hubbellc/Self-Charging-Robot/Blocks/Housing/Sheet 2.JPG

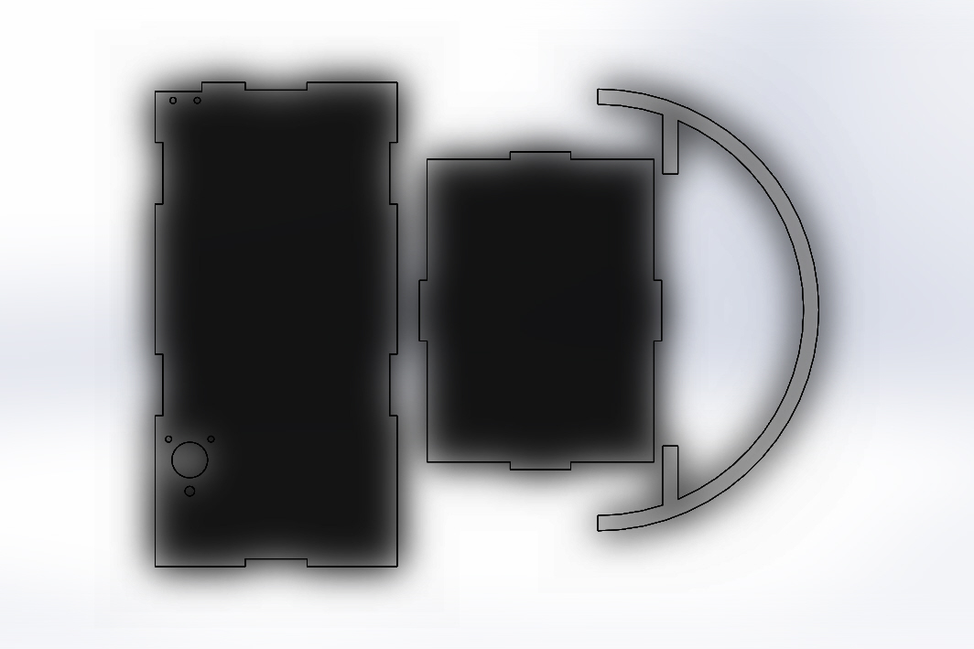
Blocks/Housing/Sheet 2.JPG
