hubbellc/Self-Charging-Robot/Robot Interface.pdf

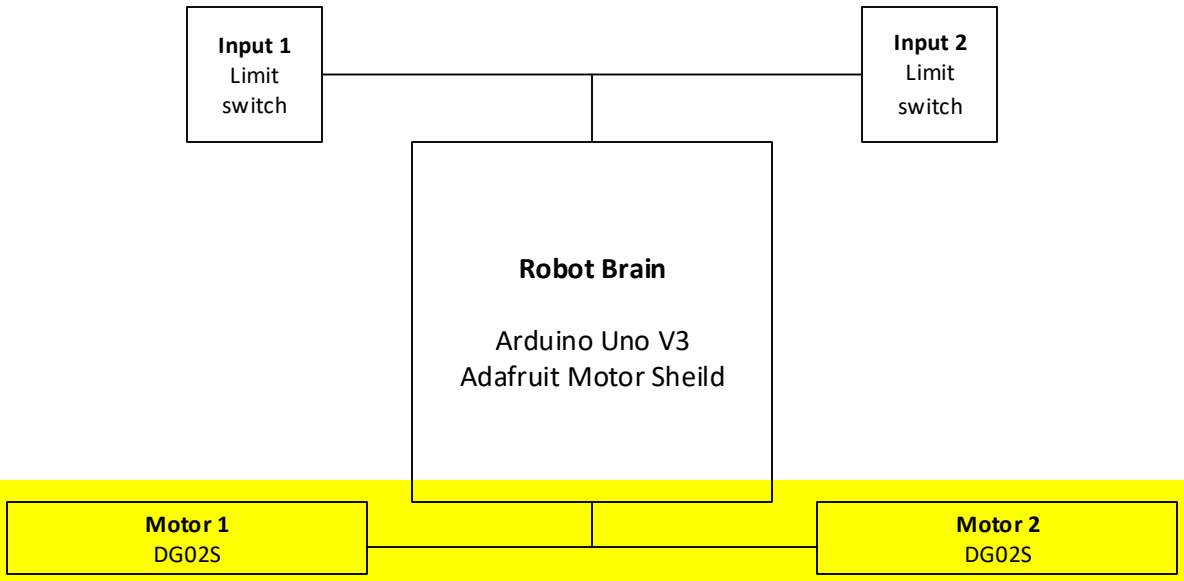
[picture p3: figure]
Robot Brain; Arduino Uno V3 Adafruit Motor Sheild; Motor 2 DG02S; Motor 1 DG02S; Input 2 Limit switch; Input 1 Limit switch
