hubbellc/Self-Charging-Robot/Blocks/Movement Block/Movement Sensing Motor Comm Block Check-Off.pdf

# All Block Check-Off

# Caleb Hubbell

# Block Diagram

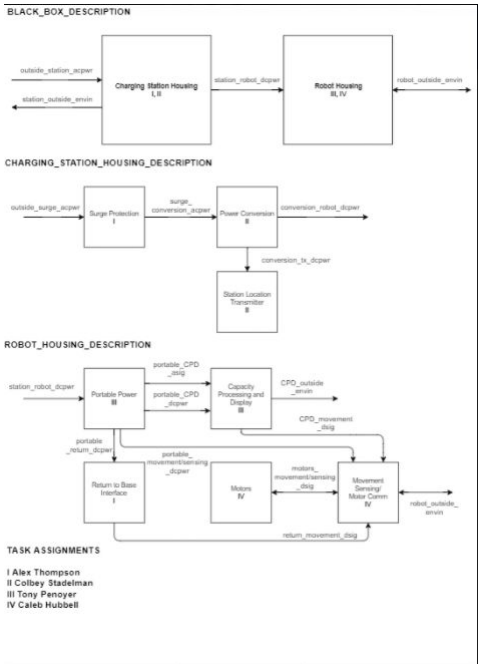
[picture p15: figure]

# Functional Overview - Motor


# Interface Verification for System Integration - Motor


Interface | Properties
robot_outside_envin | ● | Surfaces include: tile, short carpet, concrete
- Obstacles include: walls, chair legs, cords, clothing
robot_outside_motion | ● | Speed on all surfaces must be greater than 0.3 m/s
- Max speed > 0.3 m/s
- 10 min or greater time in motion
capacity/reg_motors_dcpwr | ● | 3-12 V DC
- 0 - 0.7 A
- 10% tolerance on input parameters
motors_movement/sensing_dsig | ● | PWM DC signal powering 2 motors
- PWM frequency of 1.6KHz.
- Draw of 0 - 0.45A
- Duty cycle of 0-40%
- 2 active high inputs; 5V high, 0V low

# Testing Plan Overview - Motor

## 2 Steps:

## A. Top Speed No Load Test B. Top Speed Max Current Draw Test

## Conclusion:

If the block passes all of the listed tests, all interface properties have been verified and the block is ready for inclusion into the system.

# Schematic and Testing Setup - Motor


# Test Videos - Motor

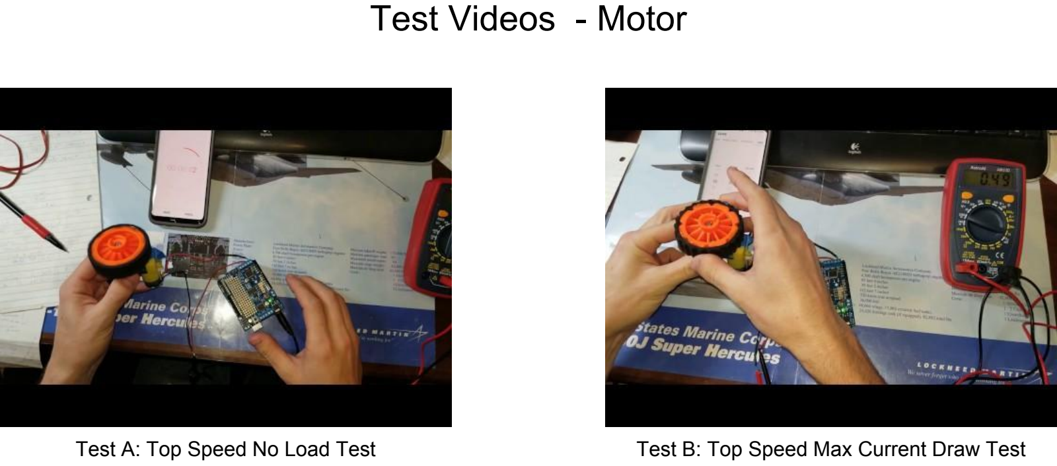
[picture p16: page 7]

Test A: Top Speed No Load Test | Test B: Top Speed Max Current Draw Test

# Test Results - Motor

### Numerical Results:

A. V = 3.53V. I = 0.1A. R = 35.5Ω. RPM = 150.

### Linear Velocity = 0.93m/s

B. V = 3.35V. I= 0.5A. R = 6.7Ω. RPM = 54.

### Linear Velocity = 0.33m/s

### Results: Passed

Both linear velocities were above the required minimum velocity of 0.3m/s. This demonstrates that the motor block is ready to be incorporated into the system for further testing and should not result in system damage or malfunctions.

# Functional Overview - Movement Sensing / Motor Comm


# Interface Verification for System Integration - Movement Sensing / Motor Comm

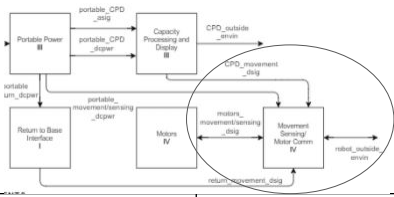
[picture p17: figure]

Interface | Properties
robot_outside_envin | ● | Surfaces include: tile, short carpet, concrete
- Obstacles include: walls, chair legs, cords, clothing
return_movement/sension_dsig | ● | Function calls which demand motor movement in all 4 directions
motors_movement/sensing_dsig | ● | PWM DC signal powering 2 motors
- PWM frequency of 1.6KHz.
- Draw of 0 - 0.45A
- Duty cycle of 0-40%
- 2 active high inputs; 5V high, 0V low

# Testing Plan Overview - Movement Sensing / Motor Comm

## 5 Steps:

## A. Setup B. Forward movement test C. Left object test D. Right object test E. Front object test

## Conclusion:

If the block passes all of the listed tests, all interface properties have been verified and the block is ready for inclusion into the system.

# Schematic and Testing Setup - Movement Sensing / Motor Comm

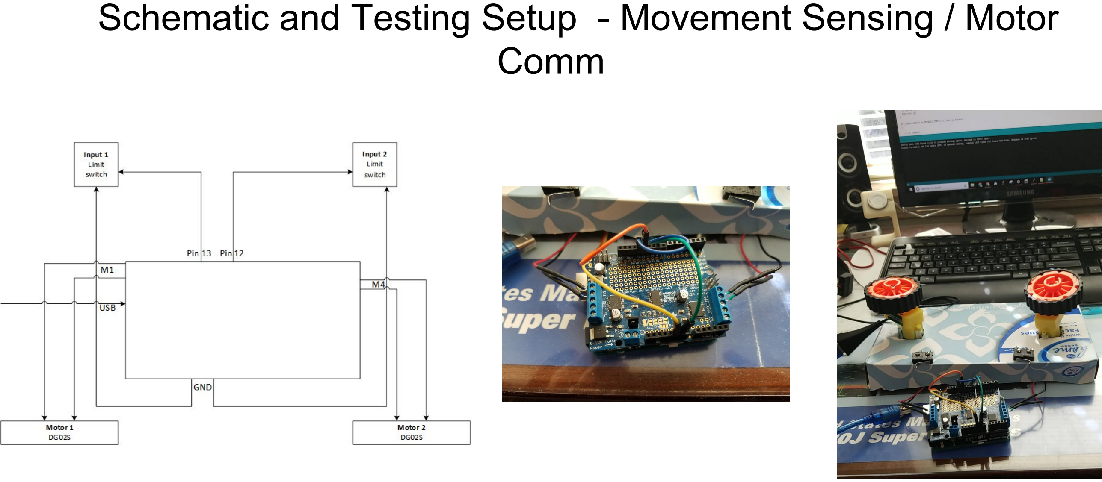
[picture p18: page 12]

# Test Video - Movement Sensing / Motor Comm

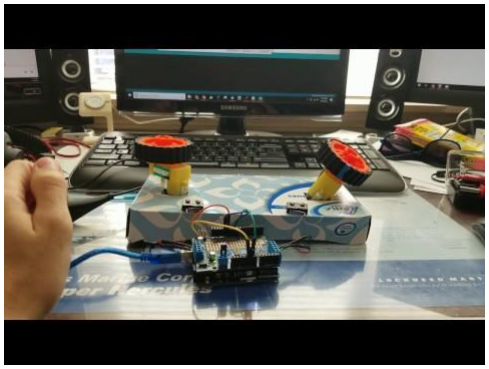
[picture p19: figure]

### Testing the object detection / avoidance

# Test Results - Movement Sensing / Motor Comm

### Results: All Passed

The robot accurately responded to all provided inputs. This demonstrates that the motor block is ready to be incorporated into the system for further testing and should not result in system damage or malfunctions.

# Add’n Block

## Robot Housing

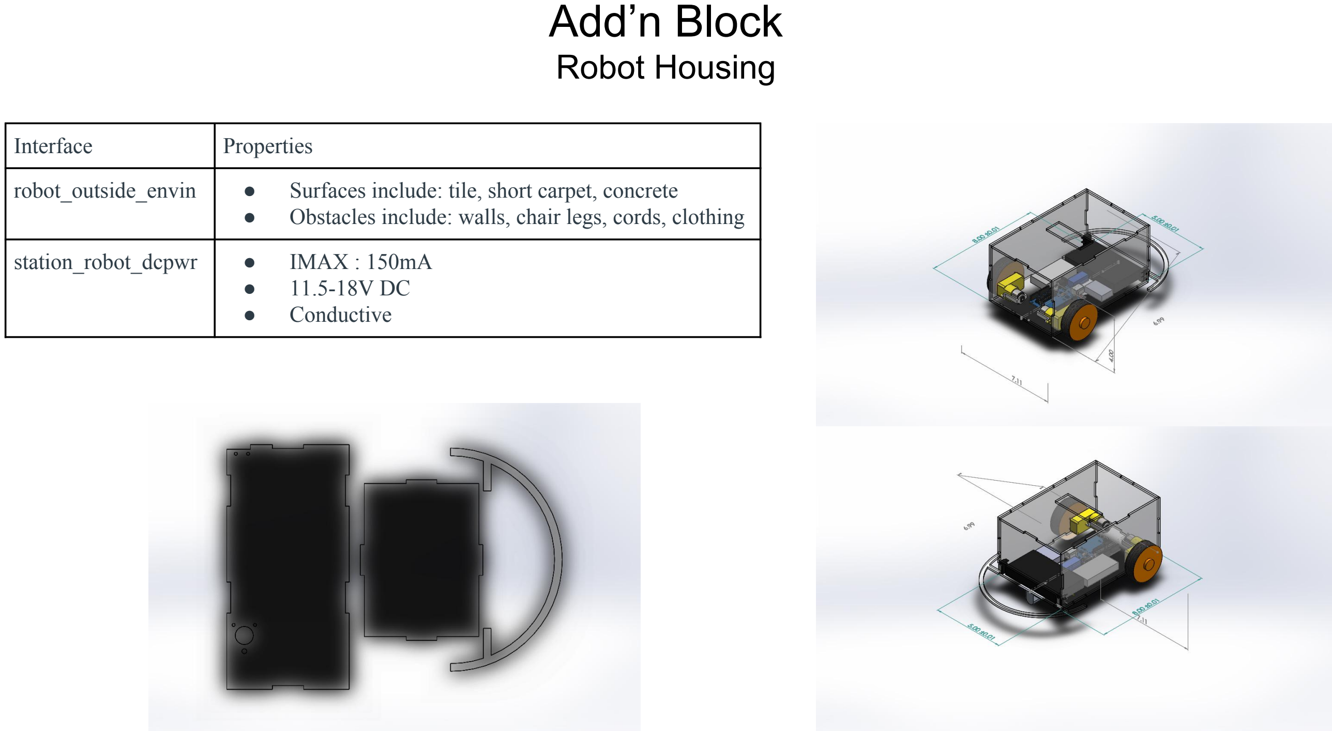
[picture p20: page 15]

Interface | Properties
robot_outside_envin | ● | Surfaces include: tile, short carpet, concrete
- Obstacles include: walls, chair legs, cords, clothing
station_robot_dcpwr | ● | IMAX : 150mA
- 11.5-18V DC
- Conductive
