hubbellc/Self-Charging-Robot/Block Diagram.pdf

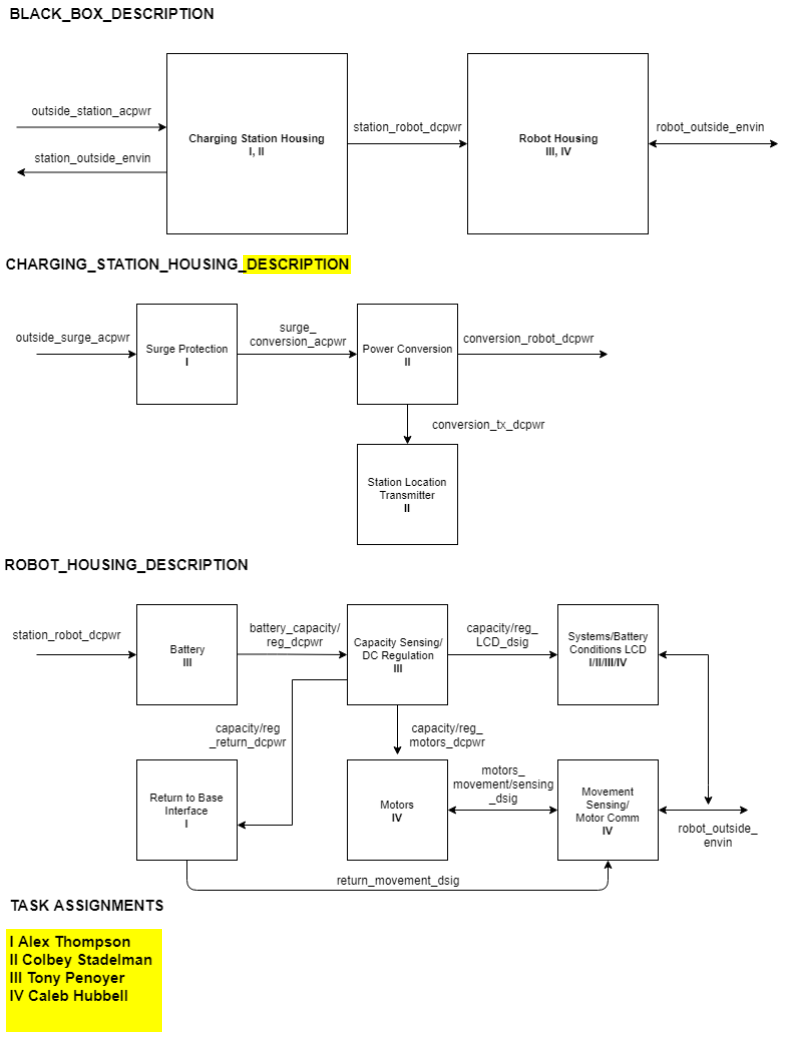
[picture p21: figure]
