hubbellc/Self-Charging-Robot/Blocks/Housing/Robot1.JPG

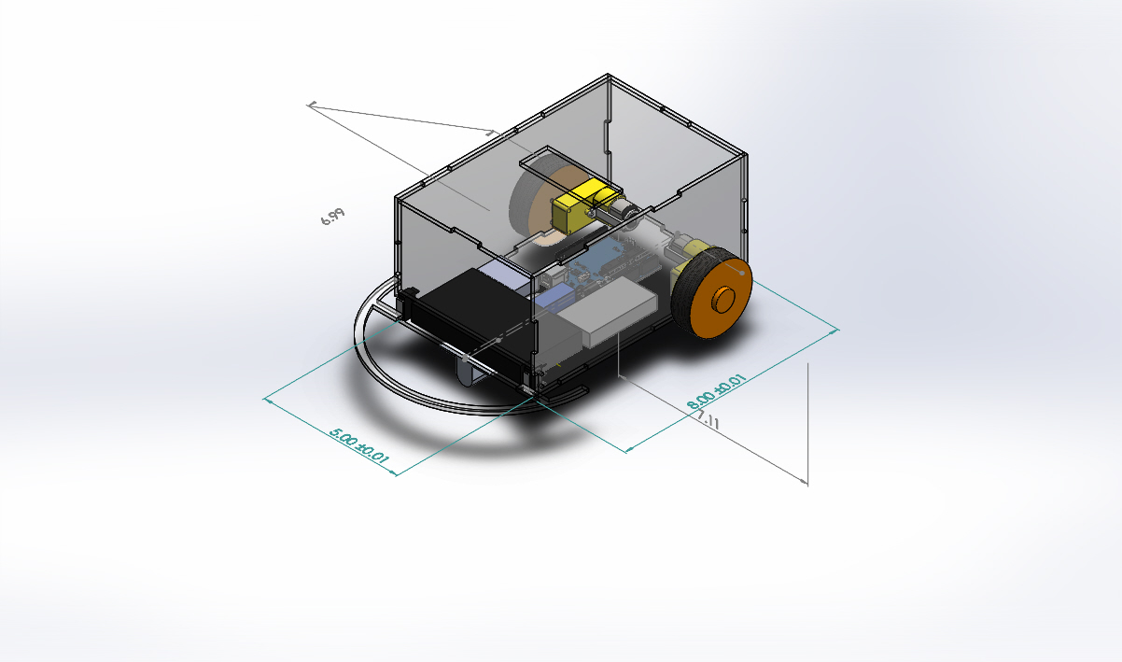
Blocks/Housing/Robot1.JPG
