hubbellc/Self-Charging-Robot/Blocks/Housing/Robot2.JPG

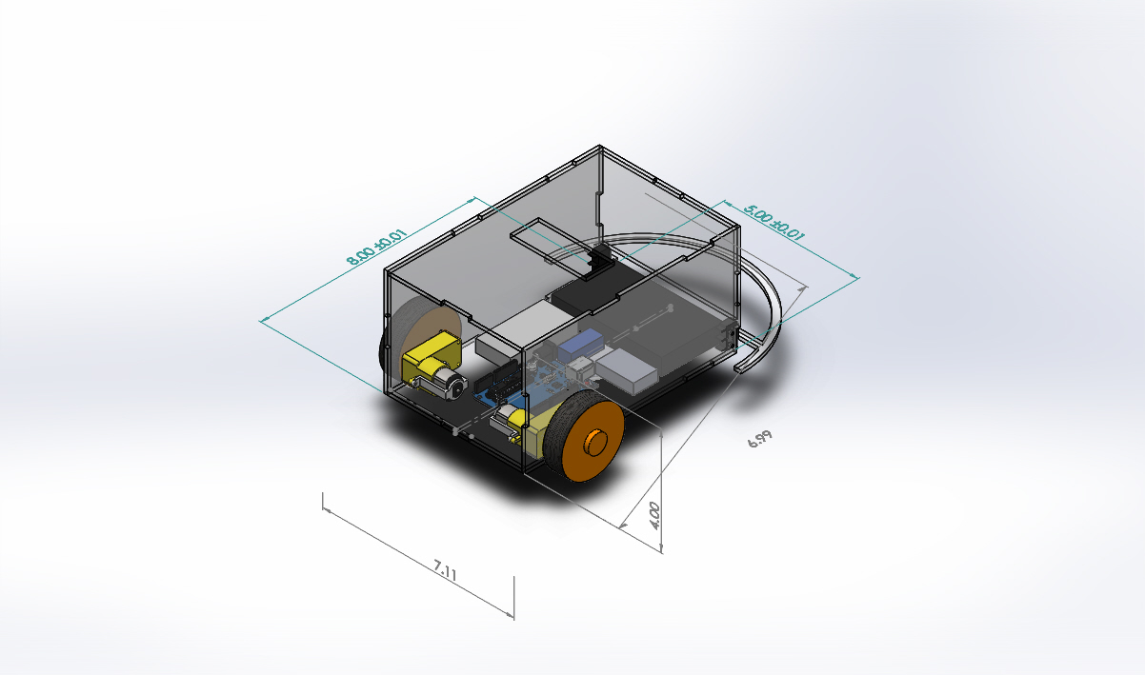
Blocks/Housing/Robot2.JPG
