hubbellc/Self-Charging-Robot/Drawings/Sheet 1.SLDASM

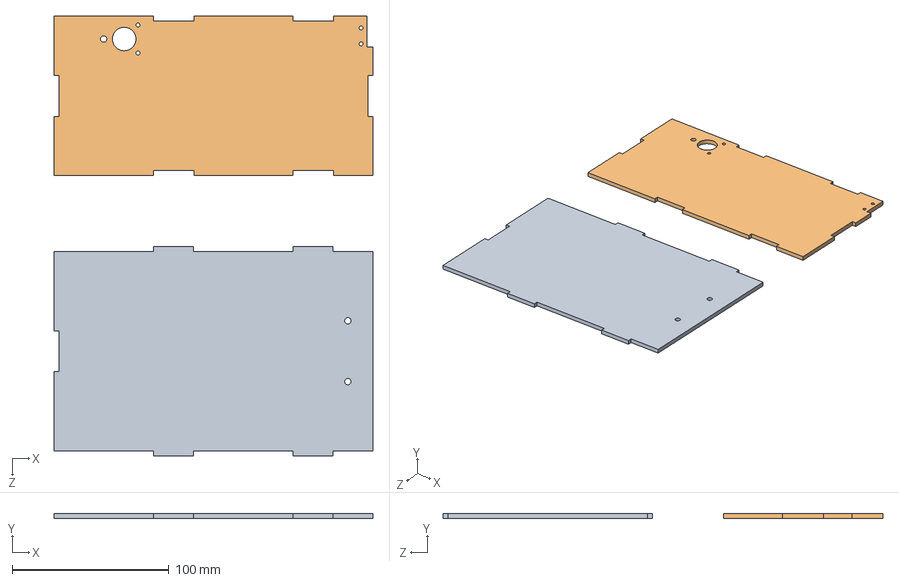
[picture p24: CAD file, 2018-05-14]
Drawings/Sheet 1.SLDASM
203.2 x 3.17 x 280.0 mm
Bottom
Long Side
