hubbellc/Self-Charging-Robot/Drawings/User Library-arduino_uno.sldasm

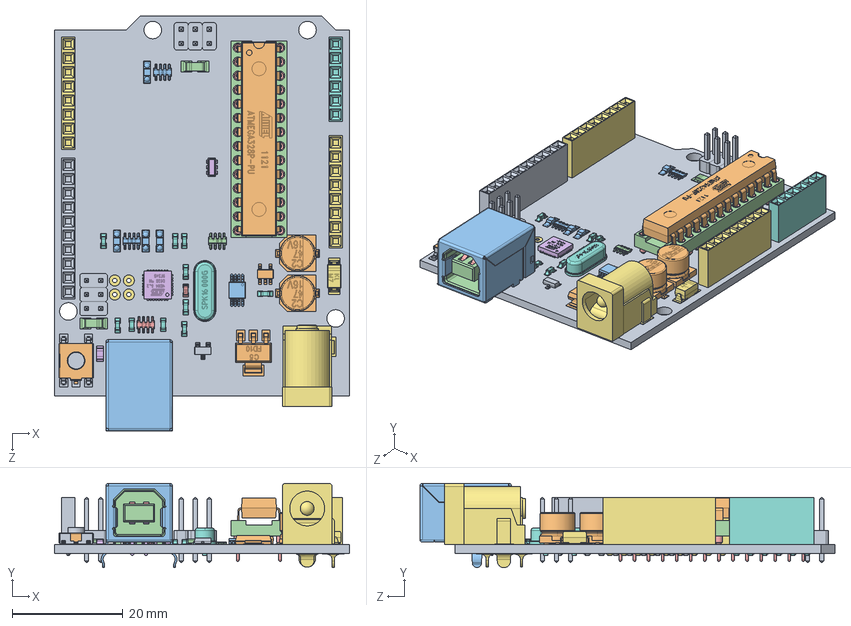
[picture p25: CAD file, 2018-05-14]
Drawings/User Library-arduino_uno.sldasm
53.3 x 15.2 x 74.9 mm
User Library-arduino_uno_unoboard blue
User Library-arduino_uno_47uf CAP Dcase x 2
User Library-arduino_uno_USB SHELL
User Library-arduino_uno_USB core
User Library-arduino_uno_usb top contact x 2
User Library-arduino_uno_usb btm contact x 2
User Library-arduino_uno_power jack
User Library-arduino_uno_crystal
User Library-arduino_uno_2pin_header__02 x 6
User Library-arduino_uno_nano - reg
User Library-arduino_uno_led x 4
User Library-arduino_uno_dip28
User Library-arduino_uno_dip socket pin x 28
User Library-arduino_uno_atmega16u2
User Library-arduino_uno_8 PORT HEADER x 2
User Library-arduino_uno_6 PORT HEADER
User Library-arduino_uno_10 PORT HEADER
User Library-arduino_uno_ATMEL328P
User Library-arduino_uno_102 RESISTOR PACK x 2
User Library-arduino_uno_103 RESISTOR PACK
User Library-arduino_uno_220 RESISTOR PACK
User Library-arduino_uno_16mhz crystal - measured
User Library-arduino_uno_PADS001
User Library-arduino_uno_603 cap on pad x 8
User Library-arduino_uno_ssot3
User Library-arduino_uno_lmv358
User Library-arduino_uno_lp2985dgkr
User Library-arduino_uno_cd1206 diode x 2
User Library-arduino_uno_603 resistor
User Library-arduino_uno_blm21
User Library-arduino_uno_m7 diode
User Library-arduino_uno_MLC0603 x 2
User Library-arduino_uno_RESET CORE
User Library-arduino_uno_RESET
