hubbellc/Self-Charging-Robot/Drawings/Sheet 3.SLDASM

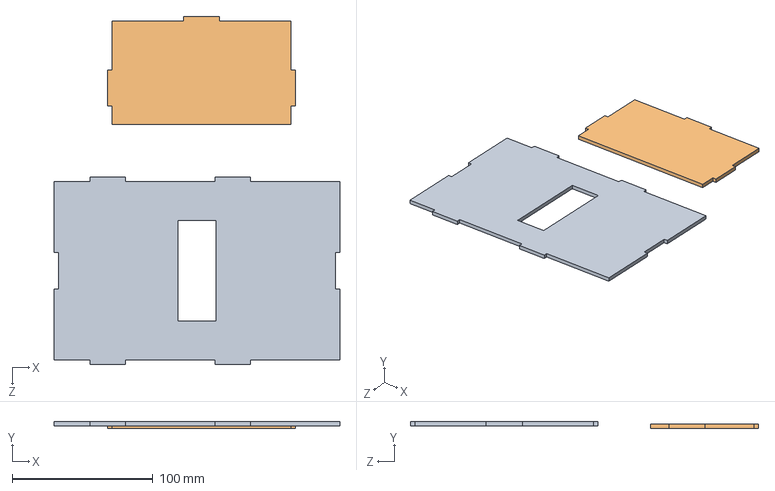
[picture p26: CAD file, 2018-05-14]
Drawings/Sheet 3.SLDASM
203.2 x 4.76 x 247.4 mm
Top
Front
