hubbellc/Self-Charging-Robot/Drawings/Sheet 2.SLDASM

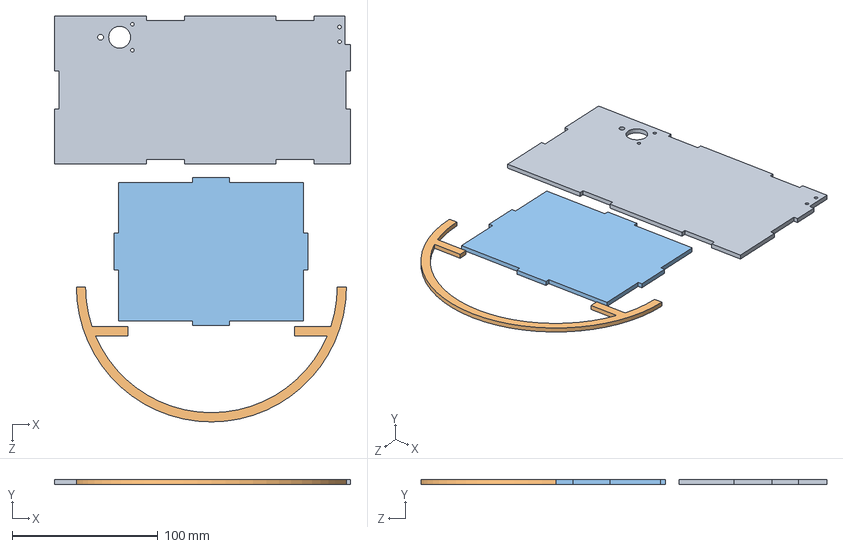
[picture p27: CAD file, 2018-05-14]
Drawings/Sheet 2.SLDASM
203.2 x 3.17 x 278.6 mm
Long Side
Bumper
Short Side
