hubbellc/Self-Charging-Robot/Drawings/JD Power.SLDPRT

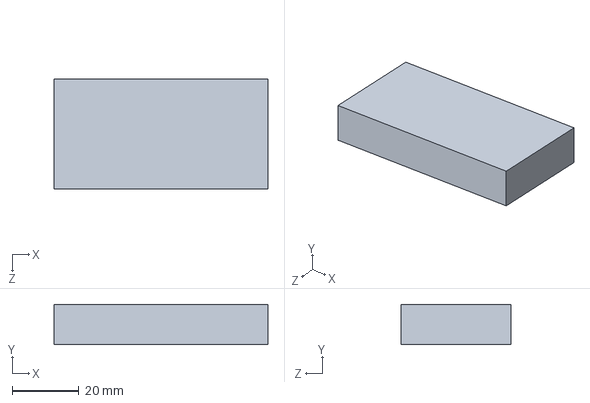
[picture p29: CAD file, 2018-05-14]
Drawings/JD Power.SLDPRT
64.0 x 12.0 x 33.0 mm
