hubbellc/Self-Charging-Robot/Drawings/Bumper.SLDPRT

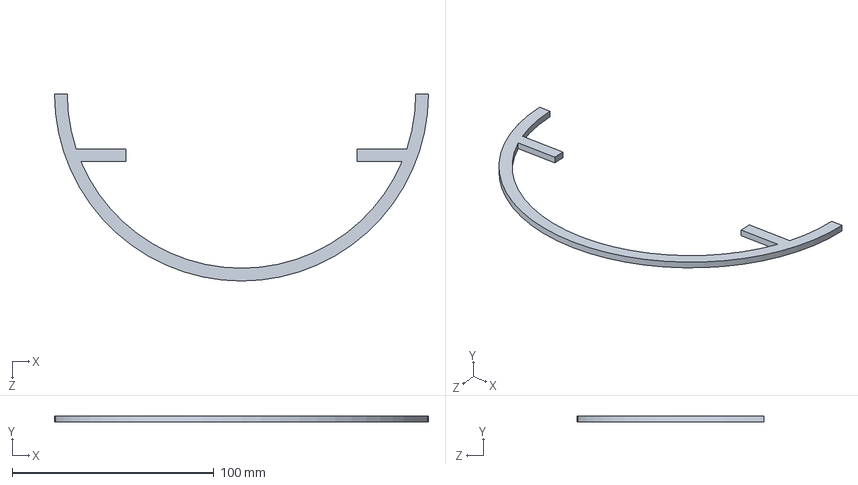
[picture p30: CAD file, 2018-05-14]
Drawings/Bumper.SLDPRT
185.4 x 3.17 x 92.7 mm
