hubbellc/Self-Charging-Robot/Drawings/Bottom.SLDPRT

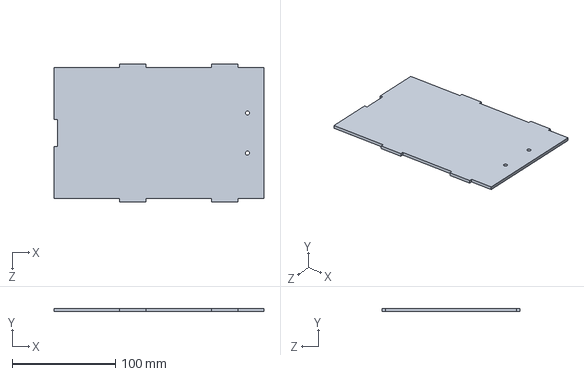
[picture p31: CAD file, 2018-05-14]
Drawings/Bottom.SLDPRT
203.2 x 3.17 x 133.4 mm
