hubbellc/Self-Charging-Robot/Drawings/Wheel.SLDPRT

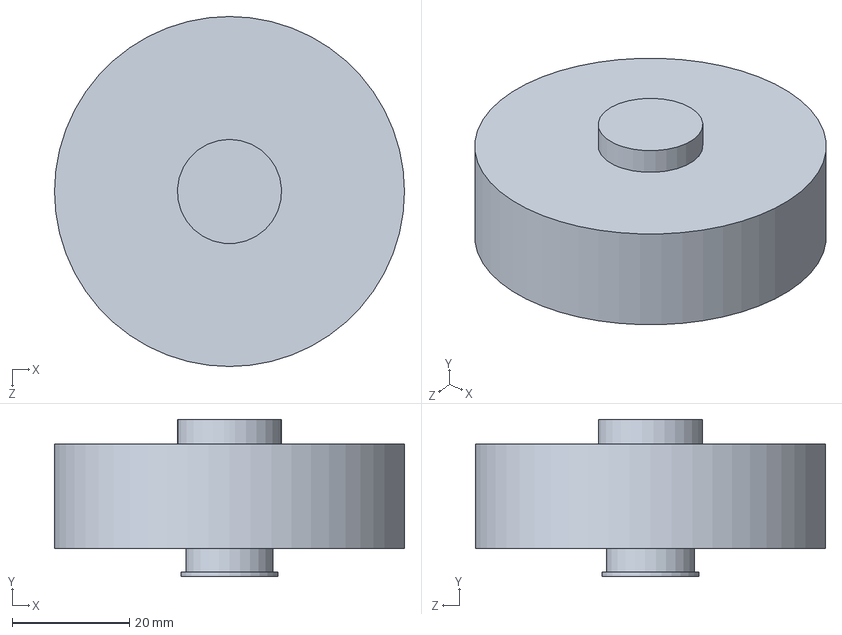
[picture p32: CAD file, 2018-05-14]
Drawings/Wheel.SLDPRT
59.7 x 26.8 x 59.7 mm
