hubbellc/Self-Charging-Robot/Drawings/Battery.SLDPRT

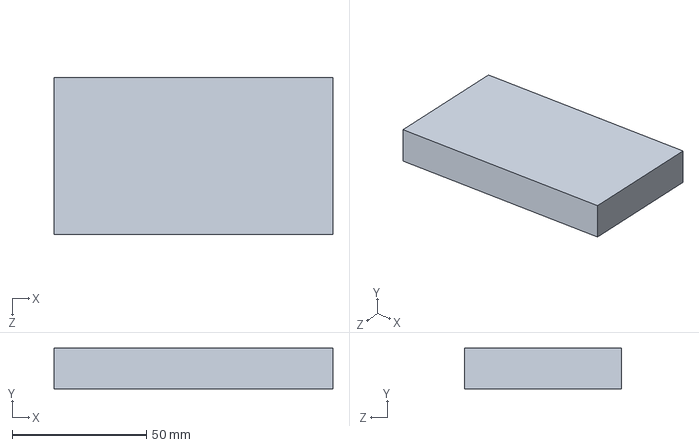
[picture p33: CAD file, 2018-05-14]
Drawings/Battery.SLDPRT
103.9 x 15.2 x 58.4 mm
