hubbellc/Self-Charging-Robot/Drawings/Front.SLDPRT

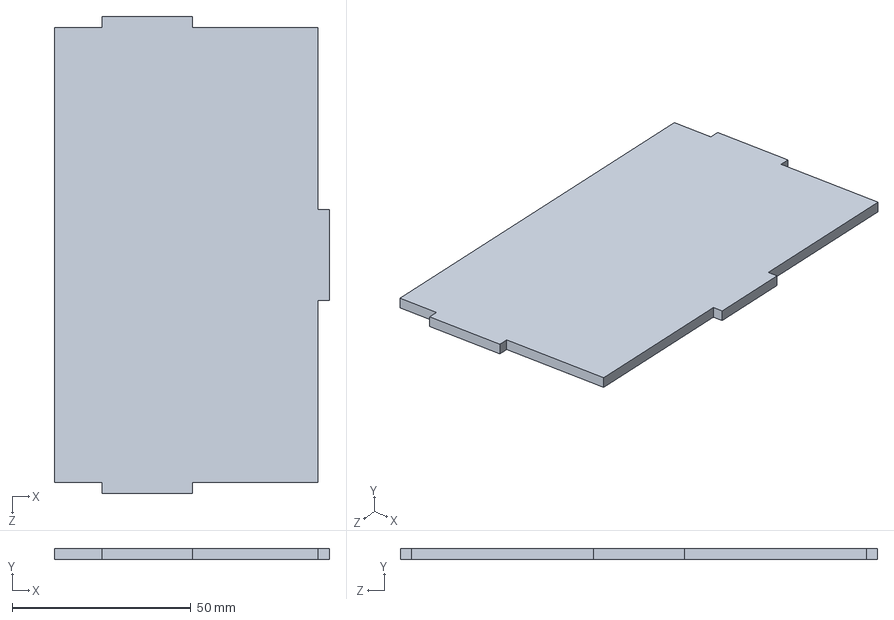
[picture p34: CAD file, 2018-05-14]
Drawings/Front.SLDPRT
76.8 x 3.17 x 133.4 mm
