hubbellc/Self-Charging-Robot/Drawings/Top.SLDPRT

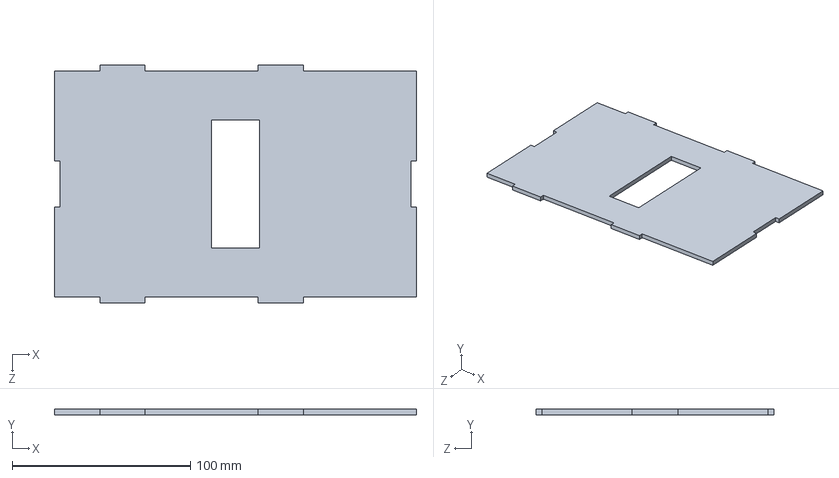
[picture p35: CAD file, 2018-05-14]
Drawings/Top.SLDPRT
203.2 x 3.17 x 133.4 mm
