hubbellc/Self-Charging-Robot/Drawings/Roller.SLDPRT

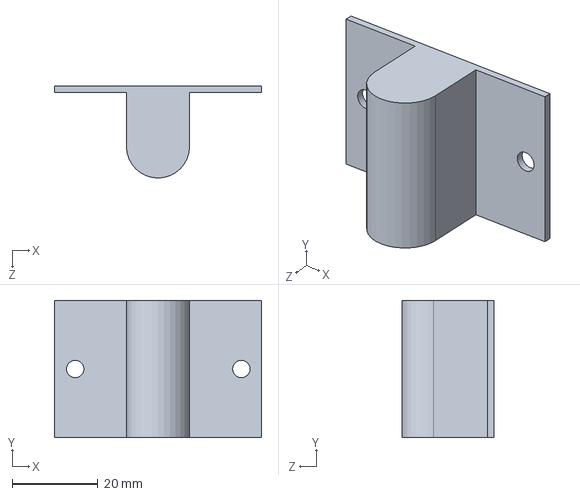
[picture p36: CAD file, 2018-05-14]
Drawings/Roller.SLDPRT
48.3 x 32.0 x 21.5 mm
