hubbellc/Self-Charging-Robot/Drawings/User Library-MINI DC GearBox DG02S 48-1.SLDPRT

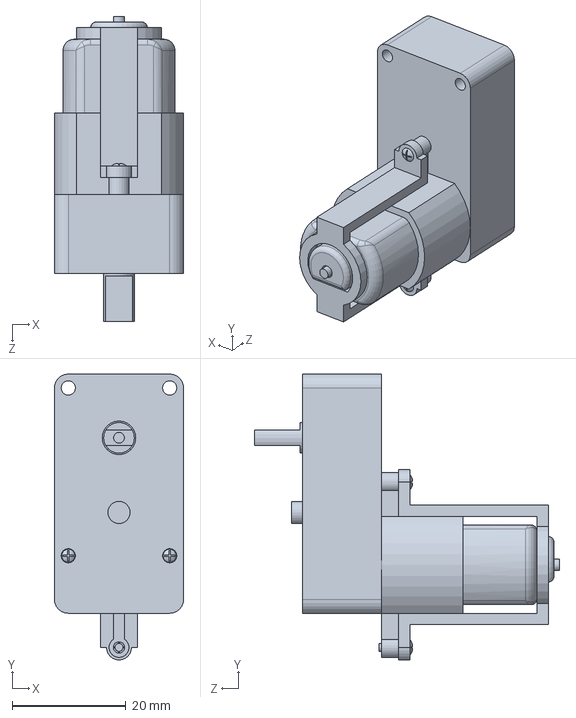
[picture p37: CAD file, 2018-05-14]
Drawings/User Library-MINI DC GearBox DG02S 48-1.SLDPRT
22.7 x 50.2 x 53.6 mm
