hubbellc/Self-Charging-Robot/Drawings/Short Side.SLDPRT

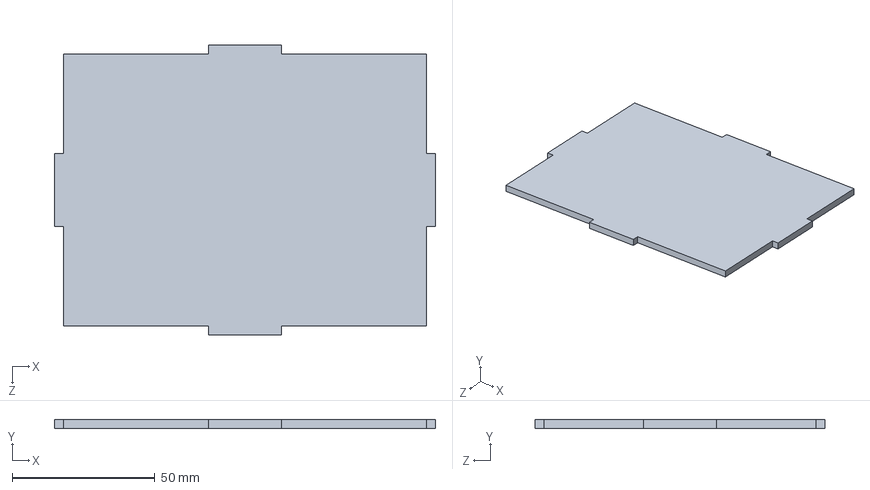
[picture p38: CAD file, 2018-05-14]
Drawings/Short Side.SLDPRT
133.3 x 3.17 x 101.6 mm
