hubbellc/Self-Charging-Robot/Drawings/Compass.SLDPRT

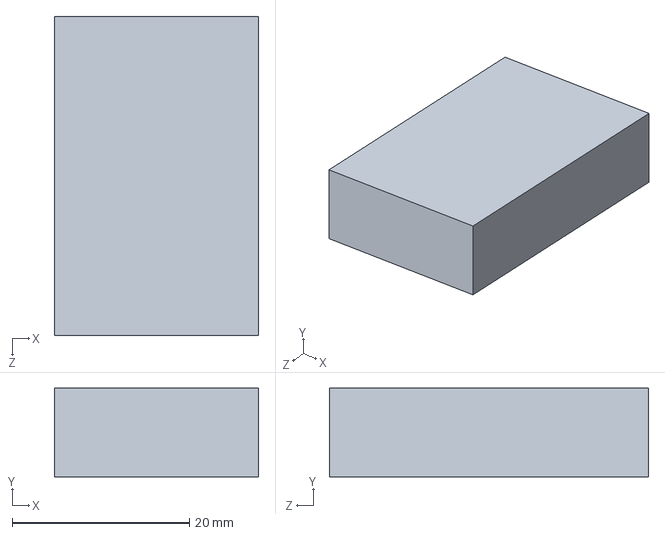
[picture p39: CAD file, 2018-05-14]
Drawings/Compass.SLDPRT
23.0 x 10.0 x 36.0 mm
