hubbellc/Self-Charging-Robot/Drawings/Long Side.SLDPRT

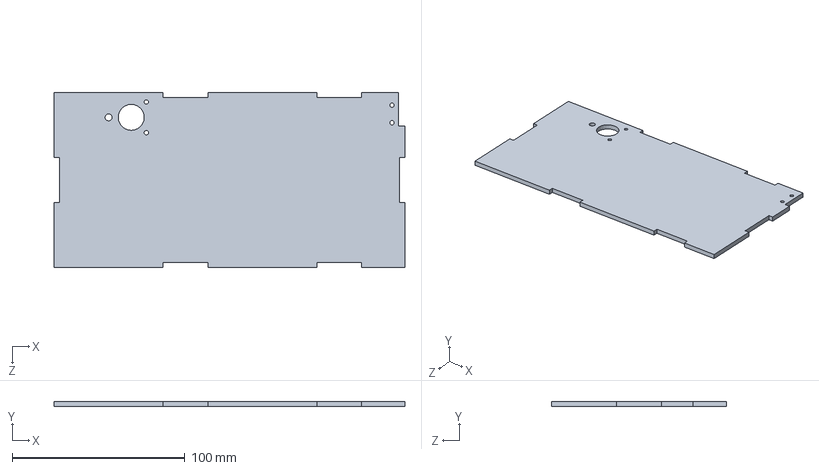
[picture p40: CAD file, 2018-05-14]
Drawings/Long Side.SLDPRT
203.2 x 3.17 x 101.6 mm
