hubbellc/Self-Charging-Robot/Drawings/ACS Module.SLDPRT

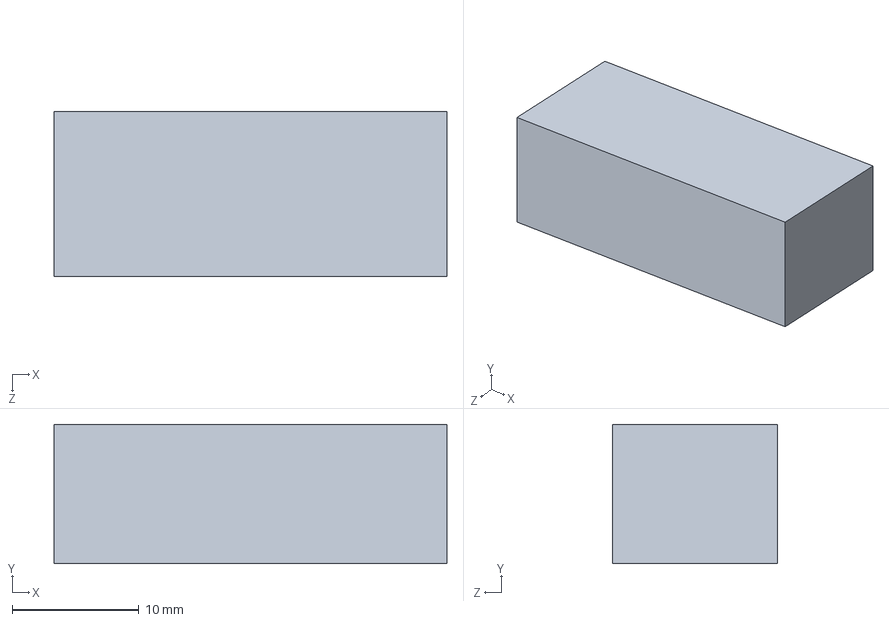
[picture p41: CAD file, 2018-05-14]
Drawings/ACS Module.SLDPRT
31.0 x 11.0 x 13.0 mm
