hubbellc/Self-Charging-Robot/Drawings/Limit Switch.SLDPRT

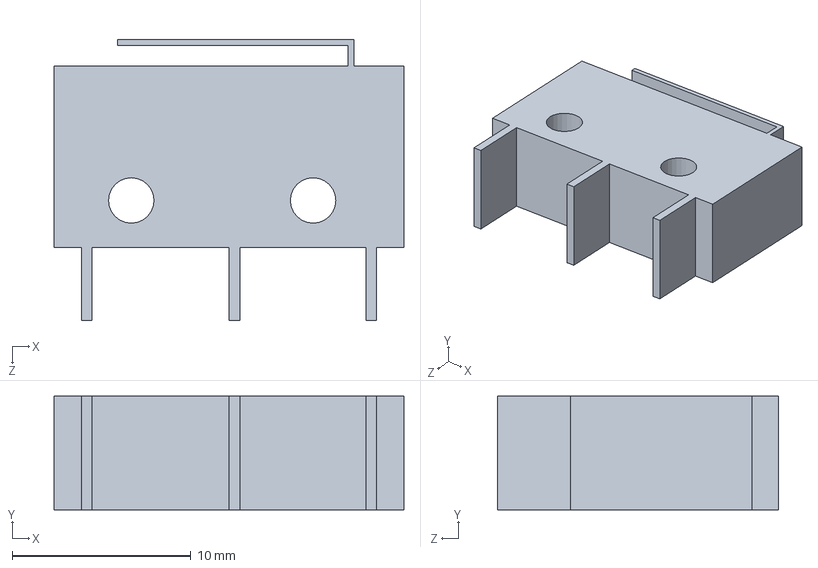
[picture p42: CAD file, 2018-05-14]
Drawings/Limit Switch.SLDPRT
19.6 x 6.35 x 15.7 mm
