hubbellc/Self-Charging-Robot/Drawings/Color Sensor.SLDPRT

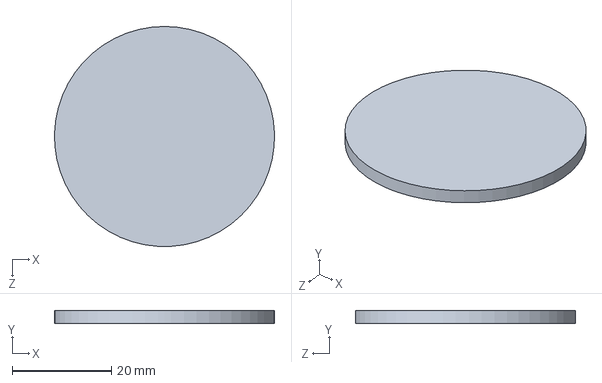
[picture p43: CAD file, 2018-05-14]
Drawings/Color Sensor.SLDPRT
44.4 x 2.54 x 44.5 mm
