hubbellc/Self-Charging-Robot/(list of files, cad)

Other CAD files:
Drawings/DXF's/Sheet 3.SLDPRT
Drawings/User Library-arduino_uno_10 PORT HEADER.sldprt
Drawings/DXF's/Sheet 2.SLDPRT
Drawings/User Library-arduino_uno_ATMEL328P.sldprt
Drawings/DXF's/Sheet 1.SLDPRT
Drawings/User Library-arduino_uno_RESET CORE.sldprt
Drawings/User Library-arduino_uno_usb top contact.sldprt
Drawings/User Library-arduino_uno_2pin_header__02.sldprt
Drawings/User Library-arduino_uno_lp2985dgkr.sldprt
Drawings/User Library-arduino_uno_usb btm contact.sldprt
Drawings/User Library-arduino_uno_16mhz crystal - measured.sldprt
Drawings/User Library-arduino_uno_crystal.sldprt
Drawings/User Library-arduino_uno_dip28.sldprt
Drawings/User Library-arduino_uno_mf-msmf050-2.sldprt
Drawings/User Library-arduino_uno_RESET.sldprt
Drawings/User Library-arduino_uno_47uf CAP Dcase.sldprt
Drawings/User Library-arduino_uno_USB core.sldprt
Drawings/User Library-arduino_uno_USB SHELL.sldprt
Drawings/User Library-arduino_uno_blm21.sldprt
Drawings/User Library-arduino_uno_led.sldprt
Drawings/User Library-arduino_uno_MLC0603.sldprt
Drawings/User Library-arduino_uno_cd1206 diode.sldprt
Drawings/User Library-arduino_uno_PADS001.sldprt
Drawings/User Library-arduino_uno_603 cap on pad.sldprt
Drawings/User Library-arduino_uno_lmv358.sldprt
Drawings/User Library-arduino_uno_nano - reg.sldprt
Drawings/User Library-arduino_uno_220 RESISTOR PACK.sldprt
Drawings/User Library-arduino_uno_power jack.sldprt
Drawings/User Library-arduino_uno_603 resistor.sldprt
Drawings/User Library-arduino_uno_6 PORT HEADER.sldprt
Drawings/User Library-arduino_uno_atmega16u2.sldprt
Drawings/User Library-arduino_uno_103 RESISTOR PACK.sldprt
Drawings/User Library-arduino_uno_dip socket pin.sldprt
Drawings/User Library-arduino_uno_8 PORT HEADER.sldprt
Drawings/User Library-arduino_uno_m7 diode.sldprt
Drawings/User Library-arduino_uno_unoboard blue.sldprt
Drawings/User Library-arduino_uno_102 RESISTOR PACK.sldprt
Drawings/User Library-arduino_uno_ssot3.sldprt
Drawings/DXF's/Sheet 1.DXF
Drawings/DXF's/Sheet 2.DXF
Drawings/DXF's/Sheet 3.DXF
