hubbellc/Self-Charging-Robot/(commit log)

2018-05-14 Week 6
    [ACS Module.SLDPRT, Battery.SLDPRT, Bottom.SLDPRT, Bumper.SLDPRT, Color Sensor.SLDPRT, Compass.SLDPRT, Front.SLDPRT, JD Power.SLDPRT]
2018-05-31 Added charge sensor
